markvdb/fosdemvideobox/README.md

# fosdemvideobox

Box for the FOSDEM.org video streaming equipment. Work in progress.

 * diagram: http://glasno.st/videobox.svg .
 * diagram source: http://glasno.st/videobox.dot .
 * rendering: http://glasno.st/videobox.png

Panel mount couplers are mounted through D-type panel holes:

D-type panel holes
