markvdb/fosdemvideobox/(threads)

Thread 1 (2015-06-22):

build in cable box at the back

markvdb, 2015-06-22:
It might be really really useful to build a cable box into the back. For what exactly:
* power cable
* minijack-minijack cable
* vga cable?
* hdmi/sdi cable?

markvdb, 2015-12-21:
Cables will be rolled around in wheeled flight cases. 4 compartments per case of 10 boxes.

Closed 2015-12-21.

Thread 3 (2015-06-23):

h264 encoder needs airflow (niobos)

markvdb, 2015-06-23:
The h264 encoder gets quite hot. It needs active airflow. Maybe we can somehow use the psu airflow for it?

markvdb, 2015-07-31:
Using the psu airflow is not possible. The intake is on the side of the power button.

Closed 2015-12-21.

Thread 5 (2015-06-24):

efficient 2d layout for laser cutting

markvdb, 2015-06-24:
build an efficient 2d layout for laser cutting the panels with cutouts.

markvdb, 2015-07-05:
added a first attempt at 2d layout on 1220*610mm sheets.

markvdb, 2015-12-21:
Cutting done.

Closed 2015-12-21.

Thread 6 (2015-06-24):

front panel recessed & round front corners

markvdb, 2015-06-24:
Recess front panel 10mm and round top and bottom panel corners accordingly.

This will help protect the connectors on the front panel.

markvdb, 2015-07-31:
wontfix. loses y axis space.

Closed 2015-07-31.

Thread 7 (2015-06-29):

hole for lock cable

markvdb, 2015-06-29:
build in a hole for lock cable (kensington, ...).  we don't _need_ to buy the locks, but this leaves open the opportunity to do so.

markvdb, 2015-08-01:
Kensington lock specifications:

http://accoblobstorageus.blob.core.windows.net/literature/Kensington_slot_specs.pdf

markvdb, 2015-12-21:
The kensington specs don't allow for 6mm wood :-(

Closed 2015-12-21.

Thread 8 (2015-06-29):

fast access to sata disk

markvdb, 2015-06-29:
Niels has requested fast access to the SATA disk. Need to think about that one...

markvdb, 2015-06-29:
Might put the whole set of electronics onto a slideable drawer, with the front panel part of the drawer. Makes it easier and cleaner to make throughholes for mounting the electronics too! This makes all parts quickly accessible. May fasten through a screw in the back cable compartment.

markvdb, 2015-07-31:
made the top panel relatively easily removable (8 tiny screws). good enough.

Closed 2015-07-31.

Thread 9 (2015-08-05):

(Gerry) acrylic protection for LCD screen?

markvdb, 2015-08-05:
Gerry:"Is the LCD covered somehow? I'm afraid it will get damaged easily if it is left exposed."

markvdb, 2015-08-05:
http://imgur.com/Gw6dMby

markvdb, 2015-12-21:
The lcd is flush with the wood. Which mens it's at least recessed compared to the panel mount adapters that are sticking out a bit, and the bolts holding the case together.

Closed 2015-12-21.

Thread 10 (2016-02-01):

Add HDMI input

Zverik, 2016-02-01:
There were issues with connecting modern laptops (esp. macbooks), because VGA output is quite rare these days.

markvdb, 2016-02-01:
Hello Ilya,

This is a known issue. Good that you're making it more explicit.

The problem is with the combination of projection and encoding hardware. The projectors are all vga. The h264 encoders can handle both (vga + mini jack audio) and hdmi (inlcuding audio) input, but they apparently get confused when switching between both.

For now, this is solved with hdmi -> vga adapters on the outside of the case.

In the future (not next year), we may change the default workflow to digital (with analog output to the projectors).

Keeping this ticket open for tracking that.

Kind regards,

Mark
