markvdb/fosdemvideobox/(commit log)

2015-06-23 [IMP] Centered view, labeled components, cleaned code
    [videobox.scad]
2015-06-24 add side panels, fix lcd & ethernet coupler text
    [videobox.scad]
2015-06-24 add vga coupler
    [videobox.scad]
2015-07-03 split 2d and 3d, add d-type front panel holes
2015-07-04 update diagram: add audio splitter, remove hdmi in
    [videobox.scad]
2015-07-04 remove provisional vga and ethernet couplers, add d-type blind plate
    [videobox.scad]
2015-07-05 diagram audio cable fix; case design panel mount couplers added
    [videobox.scad]
2015-07-05 add coupler labels
    [videobox.scad]
2015-07-05 add drawer bottom, rearrange components
    [videobox.scad]
2015-07-06 clean up global vars, add camerabox with full electric components drawer
    [camerabox.scad]
2015-07-31 start huge cleanup of camerabox.scad
    [camerabox.scad]
2015-08-03 add psu cutouts and mounting holes
    [camerabox.scad]
2015-08-05 finish front and top panel
    [camerabox.scad]
2015-08-05 change top panel to honeycomb
    [camerabox.scad]
2015-09-28 increase vga splitter hole distances
    [camerabox.scad]
2015-10-05 less wide lcd panel hole distance (Jaanis request)
    [camerabox.scad]
2015-10-05 teeth on front panel & more
    [camerabox.scad]
2015-10-12 move h264 encoder and vga splitter 15mm back
    easier to assemble vga cable into case
    [camerabox.scad]
